HackMan3D/HackMan3D-Orbit-Controller/Wiring/Orbit_Controller_Pinout.png

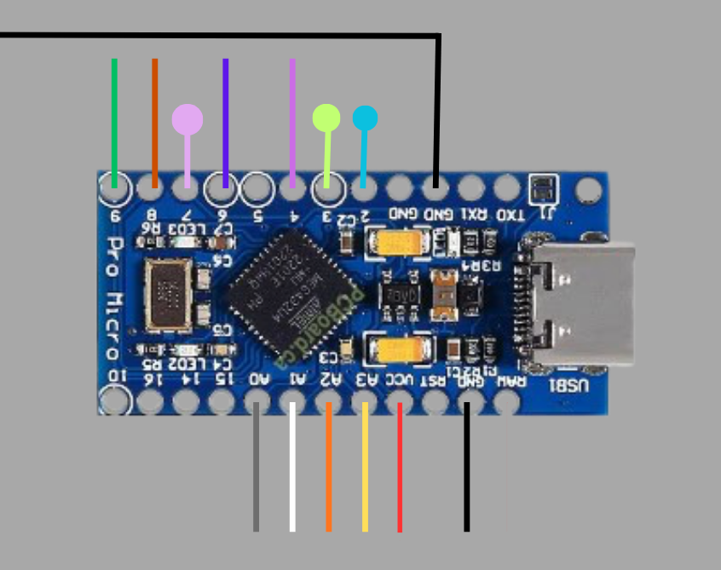
Wiring/Orbit_Controller_Pinout.png
