HackMan3D/HackMan3D-Orbit-Controller/Hackman3D_Orbit_Controller_BOM_OnePage.pdf

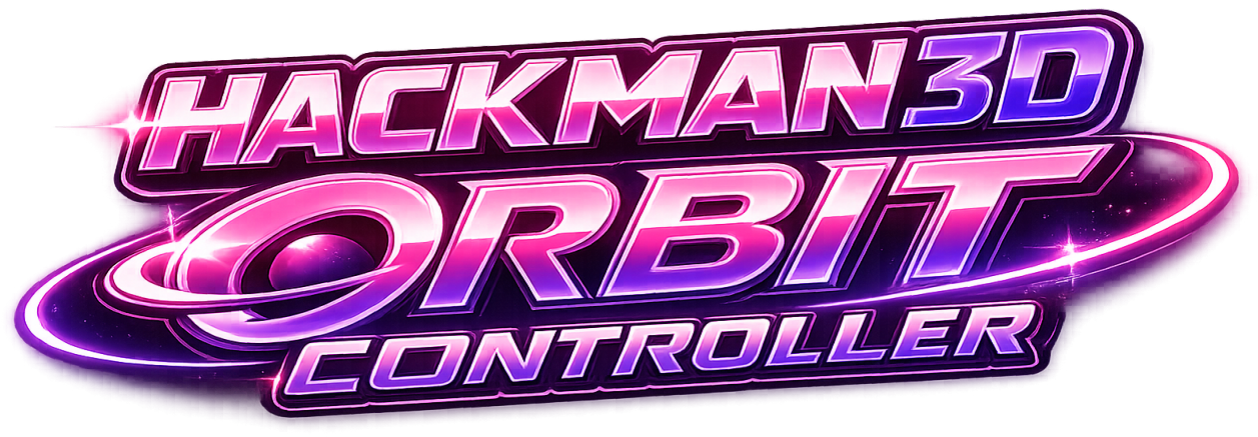
[picture p2: figure]

# Hackman3D Orbit Controller

## Bill of Materials (BOM)

Components are currently purchased individually. A complete hardware kit is planned to simplify assembly and reduce the overall cost.

Component | Qty | Ref
Hall Effect Joystick Modules | 4 | L1
Arduino Pro Micro USB‑C 5V/16MHz | 1 | L2
Dupont Wires F-F 15 cm | 1 pack | L3
MX Switches | 3 | L4
Heat Shrink Tubing | ~20 cm | Local
Hardware | Qty
M3×6 Socket Head | 4
M3×8 Socket Head | 2
M3×10 Socket Head | 4
M3×12 Socket Head | 1
M2×10 Countersunk | 4
M2×6 Countersunk | 6

## Purchase Links

L1: https://s.click.aliexpress.com/e/_c2uIckFX

L2: https://s.click.aliexpress.com/e/_c3387iWz

L3: https://s.click.aliexpress.com/e/_c4SQjq5F

L4: https://s.click.aliexpress.com/e/_c2xMo9ah

Created by Hackman3D
