HackMan3D/HackMan3D-Orbit-Controller/Documentation/HackMan3D_Orbit_Controller_BOM.pdf

# HackMan3D Orbit Controller

### Bill of Materials (BOM)

### Complete component kit - economical option

The complete Orbit component kit is now available: Buy the complete kit on AliExpress (Link #5). (https://s.click.aliexpress.com/e/_c3OkgxjX) It can cost less than buying the components individually. Compare the current total including promotions and shipping, and check the seller's included-parts list before ordering.

### Individual components

Component | Qty | Reference
Hall Effect Joystick Modules | 4 | Link #1
Arduino Pro Micro USB-C (ATmega32U4, 5V/16MHz) | 1 | Link #2
Female-Female Dupont Wires (15 cm) | 1 pack | Link #3
Mechanical Keyboard Switches (MX compatible) | 3 | Link #4
Heat Shrink Tubing | ~20 cm | Local supplier

### Standard Hardware

Hardware | Qty
M3x6 Socket Head Screws | 4
M3x8 Socket Head Screws | 2
M3x10 Socket Head Screws | 4
M3x12 Socket Head Screw | 1
M2x10 Countersunk Screws | 4
M2x6 Countersunk Screws | 6

### Purchase Links

The links below are affiliate links. Using them helps support future open-source projects at no additional cost to you. Thank you for your support!

Link #1: https://s.click.aliexpress.com/e/_c4tLXZml

Link #2: https://s.click.aliexpress.com/e/_c4VxIWkl

Link #3: https://s.click.aliexpress.com/e/_c3eOBJRX

Link #4: https://s.click.aliexpress.com/e/_c4ses8a1

Link #5: https://s.click.aliexpress.com/e/_c3OkgxjX

Created by HackMan3D
