HackMan3D/HackMan3D-Orbit-Controller/Wiring/Orbit_Controller_Wiring_Diagram.png

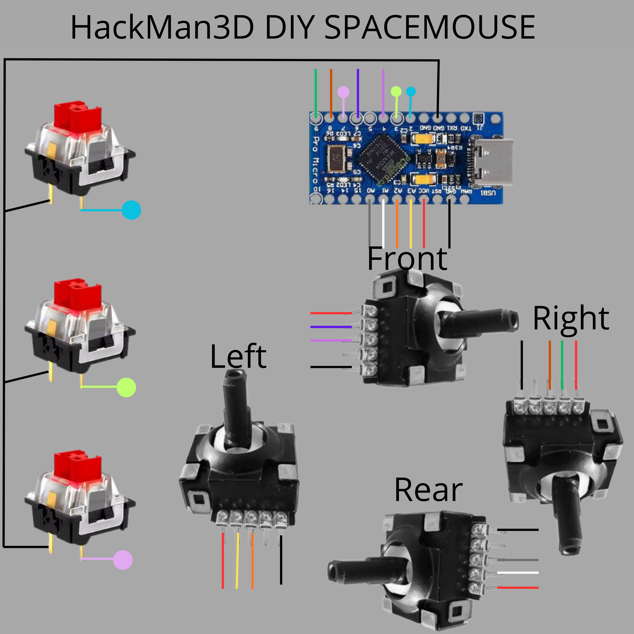
Wiring/Orbit_Controller_Wiring_Diagram.png
