HackMan3D/HackMan3D-Orbit-Controller/CHANGELOG.md

# Changelog

All notable changes to HackMan3D Orbit Controller are documented here.

The project follows [Semantic Versioning](https://semver.org/).

## [1.0.0] - 2026-07-26

### Added

- Stable Arduino Pro Micro firmware for six-axis HID navigation
- Three selectable speed profiles
- Adjustable gain, dead zones, smoothing, response curves, and axis inversion
- Optional slicer mouse-emulation mode and keyboard shortcuts
- Assembly guide, Bill of Materials, wiring diagrams, and tuning guide
- Windows, macOS, and Linux compatibility documentation

### Documentation

- Added a guided quick-start workflow
- Added structured compatibility, hardware, control, and troubleshooting sections
- Added contribution, security, issue, and pull-request guidance

[1.0.0]: https://github.com/HackMan3D/HackMan3D-Orbit-Controller/releases/tag/v1.0.0
