HackMan3D/HackMan3D-Orbit-Controller/(commit log)

2026-07-17 Update README.md
    Full assembly YouTube video
2026-09-16 Update BOM affiliate links and add complete component kit (#19)
2026-09-16 Enhance performance, live calibration, cross-talk filtering, and axis alignments. (#18)
    * Enhance performance, add live calibration, and improve axis filtering
    - Add loop-rate limiter (LOOP_INTERVAL_MS) to make smoothing consistent across PCs
    - Replace slow floating-point pow() response curve with fast quadratic blending
    - Implement proportional cross-talk suppression to minimize accidental axis bleed
    - Add on-the-fly calibration shortcut (hold all buttons for 3 seconds)
    - Make slicer keyboard macros non-blocking to prevent UI stutters
    - Optimize USB reporting to send zero packets once on release instead of spamming
    - Correct 3Dconnexion report mapping for Roll/Twist and Translation Z/Y axe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
    [Hackman3D_Orbit_Controller.ino]
