HackMan3D/HackMan3D-Orbit-Controller/(notices)

Notices in the files:
README.md:
License: AGPL-3.0
